ramco-git/Emergency-Stop-Board/ESB.step

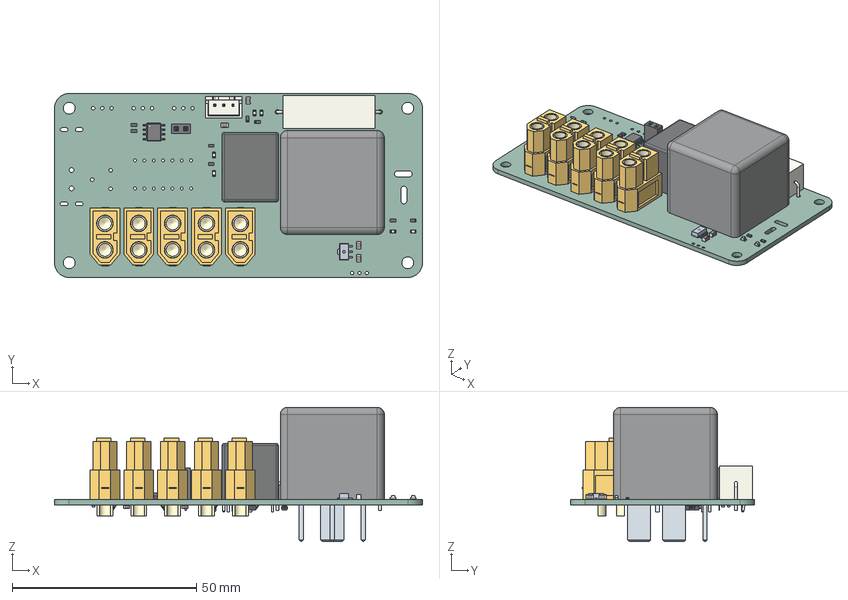
[picture p1: CAD file, 2026-10-17]
ESB.step
100.0 x 50.0 x 36.5 mm
LED_0603_1608Metric x 6
JST_XH_B3B-XH-A_1x03_P2.50mm_Vertical
R_0603_1608Metric x 12
DG85_relay
C_0805_2012Metric x 4
AMASS_XT60-F_1x02_P7.2mm_Vertical x 5
R_Axial_Power_L25.0mm_W9.0mm_P27.94mm
SOIC-8_3.9x4.9mm_P1.27mm
ESB 1.22.1
943-1C-xxDS
PinSocket_1x02_P2.54mm_Vertical
C_0603_1608Metric x 4
D_SOD-123 x 4
SOT-23-3 x 2
ESB_rev1.0_PCB
