ramco-git/Emergency-Stop-Board/items/DG85_relay.stp

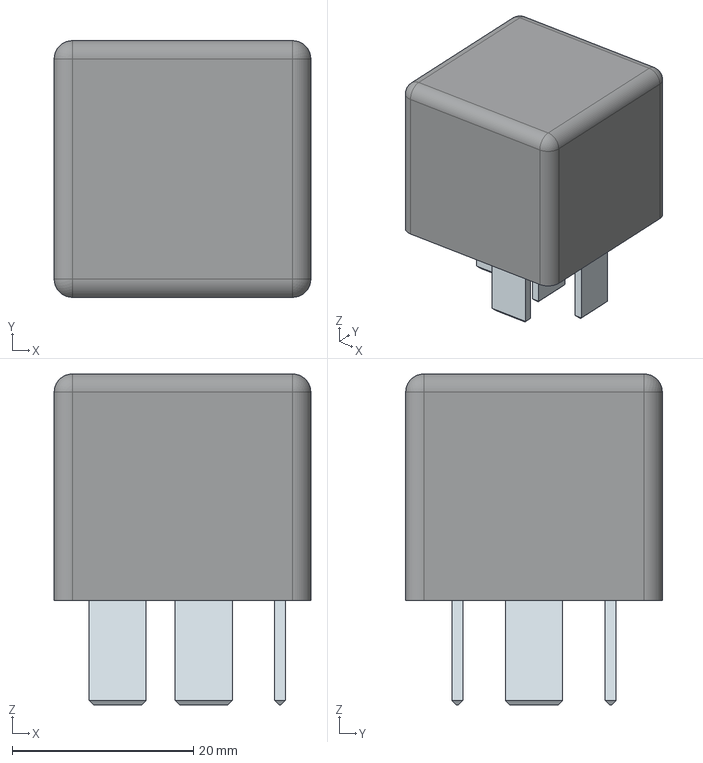
[picture p2: CAD file, 2026-10-17]
items/DG85_relay.stp
28.3 x 28.3 x 36.5 mm
