ramco-git/Emergency-Stop-Board/items/943-1C-xxDS.stp

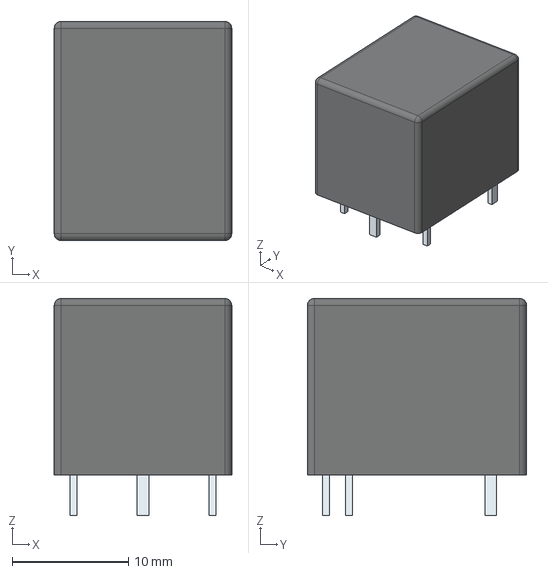
[picture p3: CAD file, 2026-10-17]
items/943-1C-xxDS.stp
15.3 x 18.9 x 18.7 mm
